stslxg/Cyber-/SmartCar/screenshot2.png

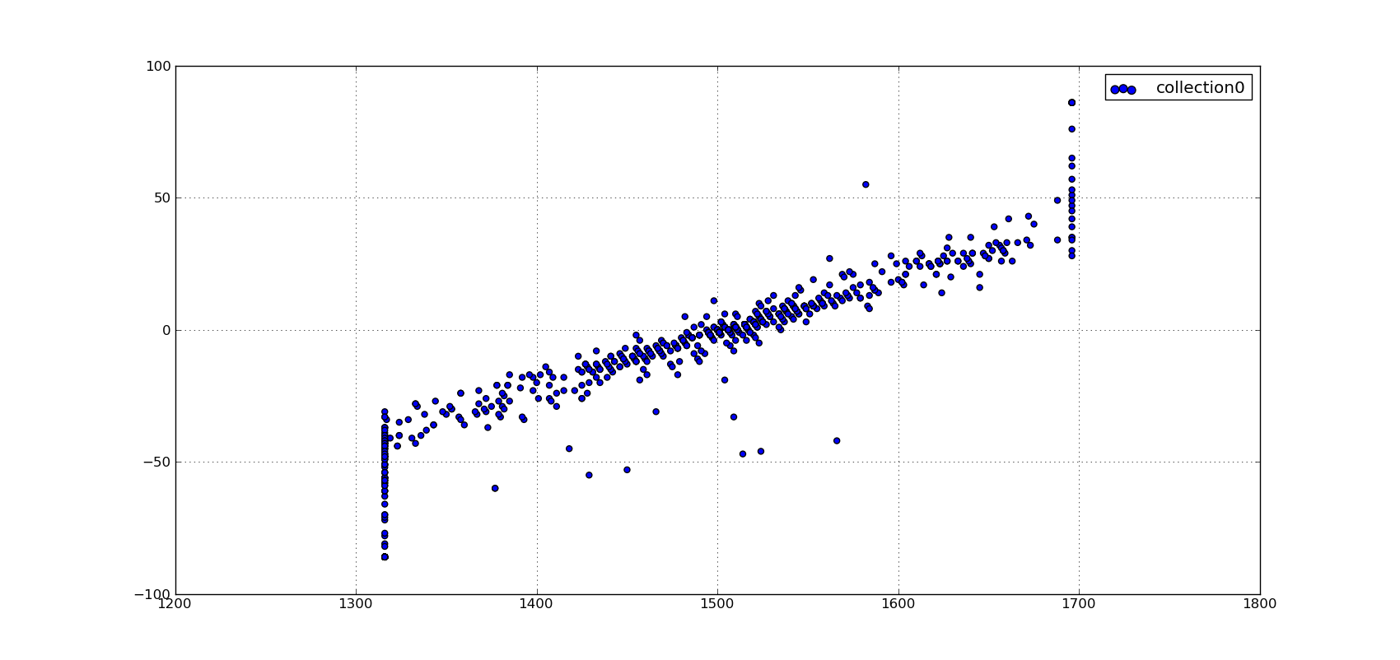
SmartCar/screenshot2.png
