stslxg/Cyber-/SmartCar/screenshot.png

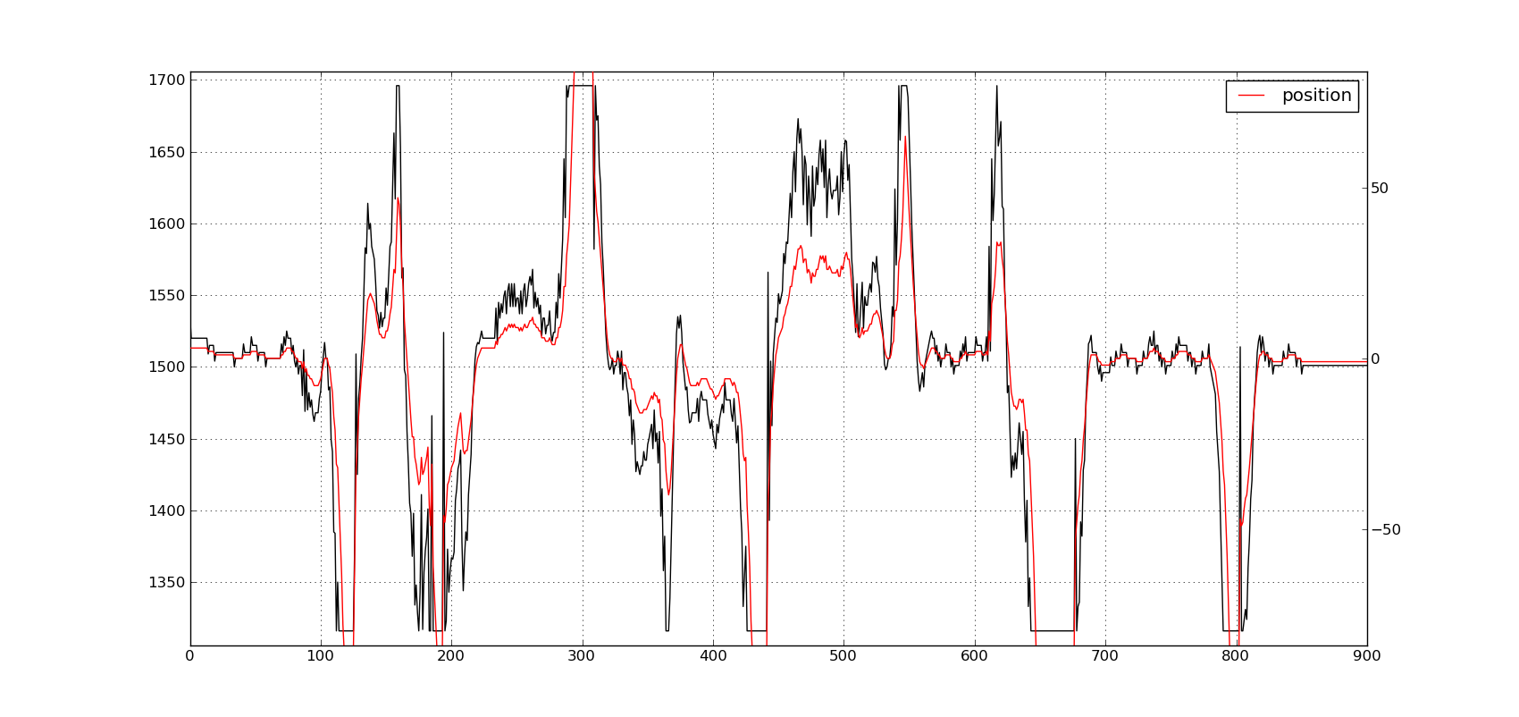
SmartCar/screenshot.png
