stslxg/Cyber-/SmartCar/showSpeed1.png

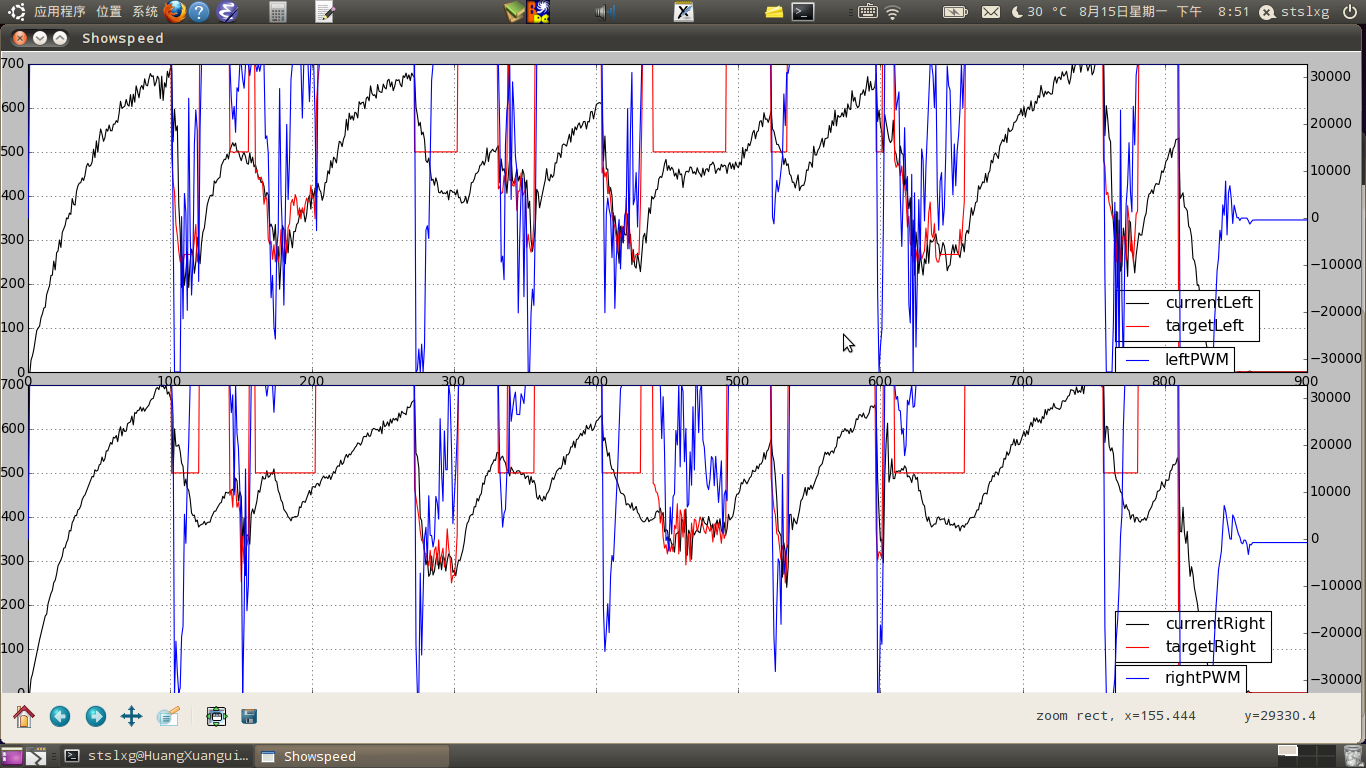
SmartCar/showSpeed1.png
