stslxg/Cyber-/SmartCar/showSpeed2.png

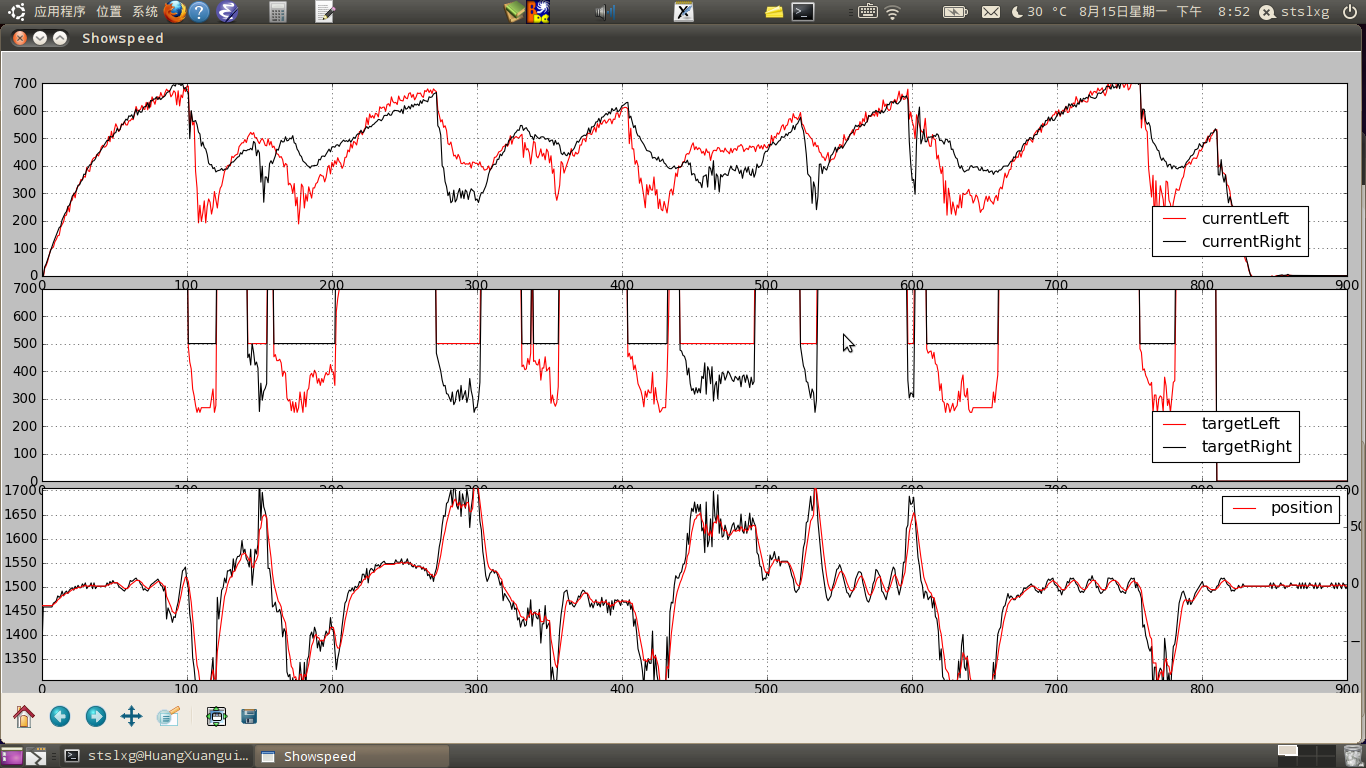
SmartCar/showSpeed2.png
