stslxg/Cyber-/SmartCar/speed.png

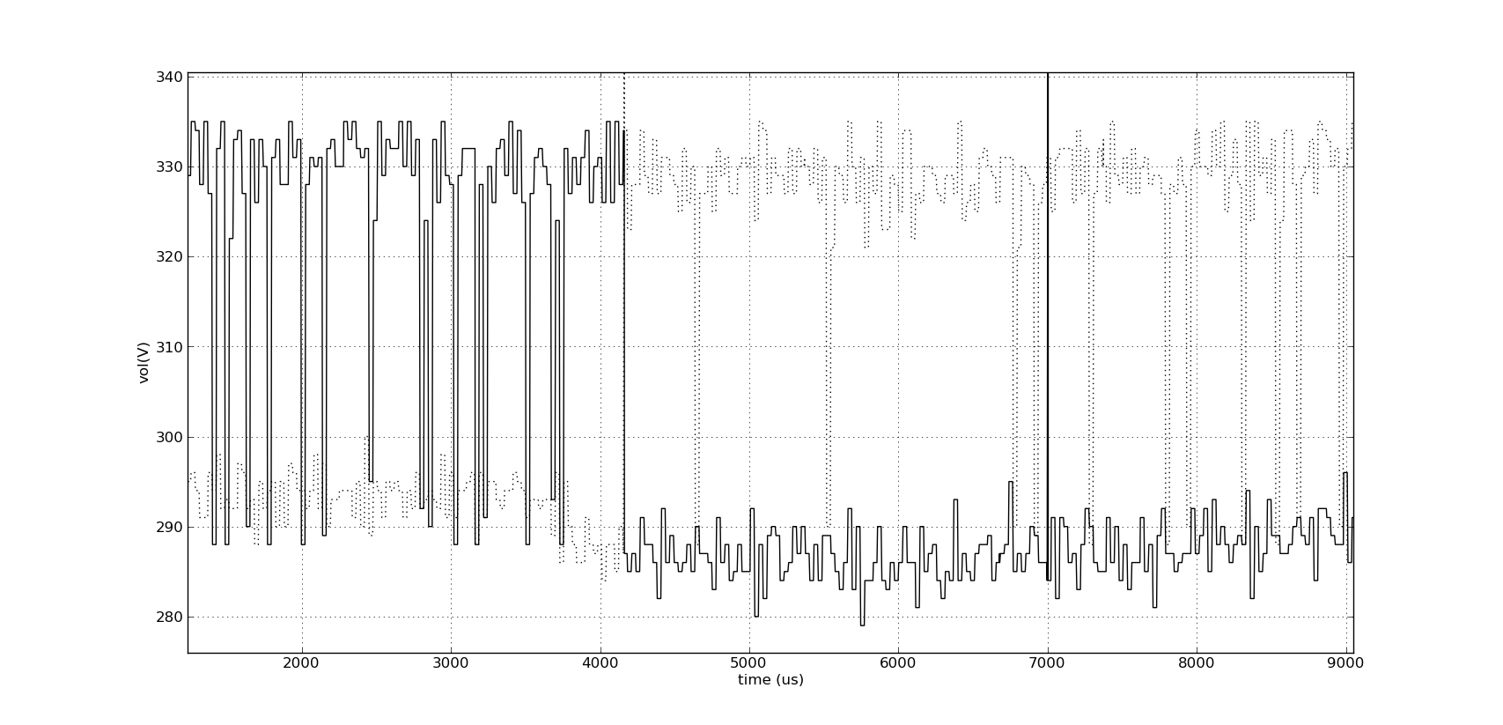
SmartCar/speed.png
