stslxg/Cyber-/SmartCar/testcamera.png

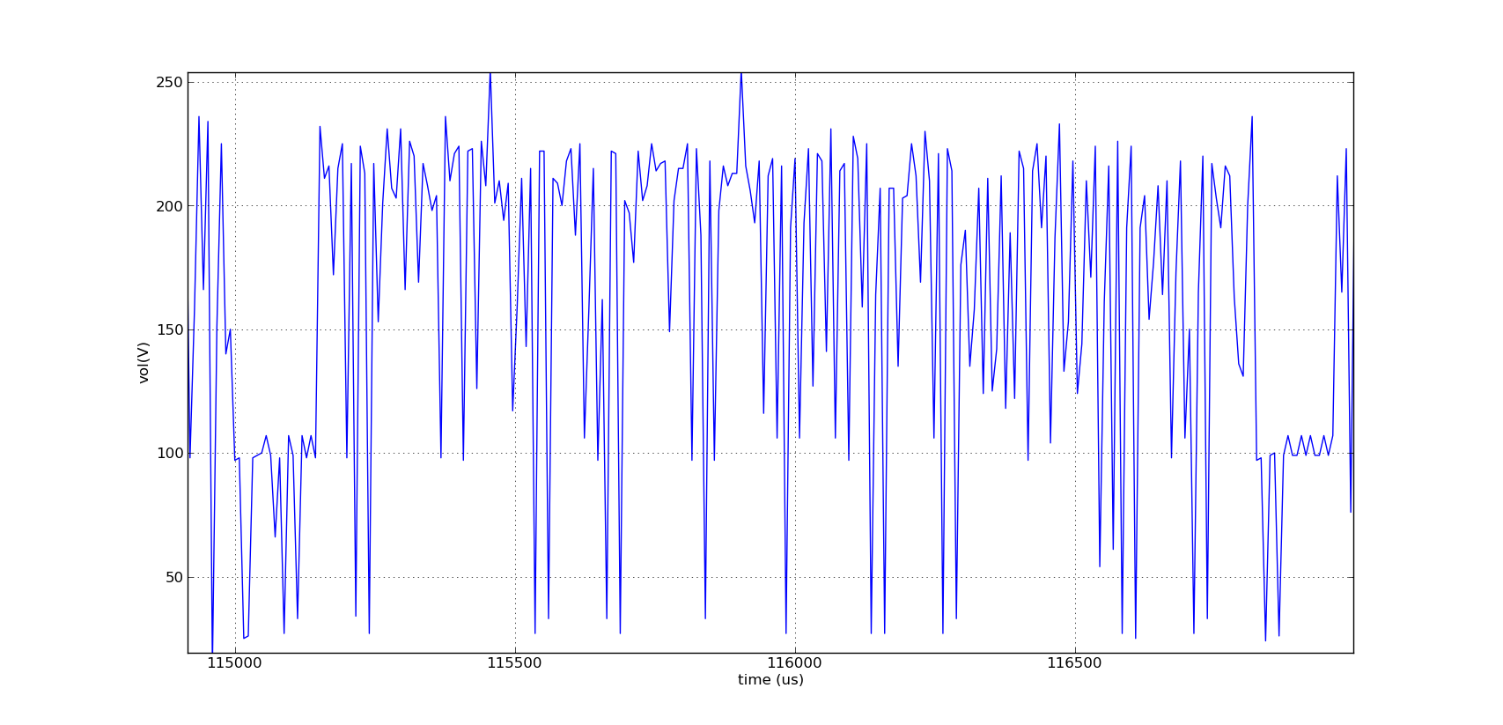
SmartCar/testcamera.png
