stslxg/Cyber-/CyberNT3_public/CODE/const.h

/** ###################################################################
**     Filename  : const.H
**     Project   : CyberNT3
**     Processor : 56F8366
**     Compiler  : Metrowerks DSP C Compiler
**     Date/Time : 2011/8/10, 16:35
**     Contents  :
**         User source code
**
** ###################################################################*/

#ifndef __const_H
#define __const_H

/* MODULE const */

#define INTERACTIVE_DELAY (4096)
#define KEY_AD_THRESHOLD (4096)
#define ROTATE_LIMIT (96)
#define SERVO_FREQUENCY (40)
#define SERVO_MIDDLE (1557 * 8)
#define SERVO_RANGE (240 * 8)

/* END const */

#endif
