stslxg/Cyber-/CyberNT3_public/CODE/Events.c

/** ###################################################################
**     Filename  : Events.C
**     Project   : CyberNT3
**     Processor : 56F8366
**     Component : Events
**     Version   : Driver 01.03
**     Compiler  : Metrowerks DSP C Compiler
**     Date/Time : 2011/8/10, 9:56
**     Abstract  :
**         This is user's event module.
**         Put your event handler code here.
**     Settings  :
**     Contents  :
**         No public methods
**
** ###################################################################*/
/* MODULE Events */

#include "Cpu.h"
#include "Events.h"

/* User includes (#include below this line is not maintained by Processor Expert) */
#include "world.h"

/*
** ===================================================================
**     Event       :  TMR_OnInterrupt (module Events)
**
**     Component   :  TMR [TimerInt]
**     Description :
**         When a timer interrupt occurs this event is called (only
**         when the component is enabled - <Enable> and the events are
**         enabled - <EnableEvent>). This event is enabled only if a
**         <interrupt service/event> is enabled.
**     Parameters  : None
**     Returns     : Nothing
** ===================================================================
*/
#pragma interrupt called /* Comment this line if the appropriate 'Interrupt preserve registers' property */
                         /* is set to 'yes' (#pragma interrupt saveall is generated before the ISR)      */
void TMR_OnInterrupt(void)
{
	DrvIrqHandler();
	HmiIrqHandler();
}

/*
** ===================================================================
**     Event       :  AFE_VSYNC_OnInterrupt (module Events)
**
**     Component   :  AFE_VSYNC [ExtInt]
**     Description :
**         This event is called when an active signal edge/level has
**         occurred.
**     Parameters  : None
**     Returns     : Nothing
** ===================================================================
*/
#pragma interrupt called /* Comment this line if the appropriate 'Interrupt preserve registers' property */
                         /* is set to 'yes' (#pragma interrupt saveall is generated before the ISR)      */
void AFE_VSYNC_OnInterrupt(void)
{
	AfeVsyncHandler();
}


/*
** ===================================================================
**     Event       :  AFE_HSYNC_OnInterrupt (module Events)
**
**     Component   :  AFE_HSYNC [ExtInt]
**     Description :
**         This event is called when an active signal edge/level has
**         occurred.
**     Parameters  : None
**     Returns     : Nothing
** ===================================================================
*/
#pragma interrupt called /* Comment this line if the appropriate 'Interrupt preserve registers' property */
                         /* is set to 'yes' (#pragma interrupt saveall is generated before the ISR)      */
void AFE_HSYNC_OnInterrupt(void)
{
	AfeHsyncHandler();
}


/*
** ===================================================================
**     Event       :  AS_OnRxChar (module Events)
**
**     Component   :  AS [AsynchroSerial]
**     Description :
**         This event is called after a correct character is
**         received.
**         The event is available only when the <Interrupt
**         service/event> property is enabled and either the
**         <Receiver> property is enabled or the <SCI output mode>
**         property (if supported) is set to Single-wire mode.
**         Version specific information for Freescale 56800
**         derivatives ] 
**         DMA mode:
**         If DMA controller is available on the selected CPU and
**         the receiver is configured to use DMA controller then
**         this event is disabled. Only OnFullRxBuf method can be
**         used in DMA mode.
**     Parameters  : None
**     Returns     : Nothing
** ===================================================================
*/
#pragma interrupt called /* Comment this line if the appropriate 'Interrupt preserve registers' property */
                         /* is set to 'yes' (#pragma interrupt saveall is generated before the ISR)      */
void AS_OnRxChar(void)
{
	SciIrqHandler();
}

/*
** ===================================================================
**     Event       :  BATT_OnEnd (module Events)
**
**     Component   :  BATT [ADC]
**     Description :
**         This event is called after the measurement (which consists
**         of <1 or more conversions>) is/are finished.
**         The event is available only when the <Interrupt
**         service/event> property is enabled.
**     Parameters  : None
**     Returns     : Nothing
** ===================================================================
*/
#pragma interrupt called /* Comment this line if the appropriate 'Interrupt preserve registers' property */
/* END Events */

/*
** ###################################################################
**
**     This file was created by Processor Expert 3.00 [04.35]
**     for the Freescale 56800 series of microcontrollers.
**
** ###################################################################
*/
