stslxg/Cyber-/CyberNT3_public/CODE/rtl.c

/** ###################################################################
**     Filename  : rtl.C
**     Project   : CyberNT3
**     Processor : 56F8366
**     Compiler  : Metrowerks DSP C Compiler
**     Date/Time : 2011/8/11, 12:39
**     Contents  :
**         User source code
**
** ###################################################################*/

/* MODULE rtl */

#include "world.h"

/* END rtl */
